NekoCoaster/inf2004-embedded-systems-project/dashboard/README.md

# MQTT Dashboard 
The MQTT Dashboard visualise the Urban Farming sensor readings transmitted to the MQTT Broker. The implementation incorporates references from the associated GitHub repository: https://github.com/donskytech/mqtt-custom-dashboard-node-js
  
## Getting Started
### Setup
Ensure that Node.js is installed on your workstation.

Install the dependencies and run the project
``` npm install && npm run dev ```

## Access the Dashboard
Visit http://localhost:3000/ in your web browser to access the MQTT Dashboard.
