NekoCoaster/inf2004-embedded-systems-project/drivers/FS3000_airflow_mqtt/FS3000_Rebuilt.h

#ifndef FS3000_Rebuilt_h
#define FS3000_Rebuilt_h

#include "i2c_tools.h"

#define FS3000_TO_READ 5 // Number of Bytes Read:
                         // [0]Checksum, [1]data high, [2]data low,
                         // [3]generic checksum data, [4]generic checksum data

#define FS3000_DEVICE_ADDRESS 0x28 // Note, the FS3000 does not have an adjustable address.
#define AIRFLOW_RANGE_7_MPS 0x00   // FS3000-1005 has a range of 0-7.23 meters per second
#define AIRFLOW_RANGE_15_MPS 0x01  // FS3000-1015 has a range of 0-15 meters per second

bool FS3000_begin(); // Initialize I2C Port in here
bool FS3000_isConnected();
uint16_t FS3000_readRaw();
float FS3000_readMetersPerSecond();
float FS3000_readMilesPerHour();
void FS3000_setRange(uint8_t range);

void FS3000_readData(uint8_t *buffer_in);

/*
 * @param data_in: 5 Bytes Buffer
 * @param debug: print debug info (default: false)
 */
bool FS3000_checksum(uint8_t *data_in, bool debug);
void FS3000_printHexByte(uint8_t x);

#endif // FS3000_Rebuilt_h
