NekoCoaster/inf2004-embedded-systems-project/(commit log)

2023-10-08 Added documentation for 5V PWM Fan Driver
2023-10-08 Updated README.md for 5v-pwm-fan driver, and added .drawio file for circuit diagram
2023-10-10 Updated README.md for the 5v-pwm-fan driver
2023-10-21 Added base PWM fan driver code...
2023-11-12 De-coupled source code and docs, added lwip testing code & cleaned house
2023-11-13 Added MQTT Test Code and patched lwipopts.h to fix sys_timeout: timeout != NULL, pool MEMP_SYS_TIMEOUT is empty
    [lwipopts.h]
2023-11-13 Added WS2812B driver code
2023-11-13 Updated led test code to use my favorite colours instead
2023-11-20 Added a bunch of goodies
    Added new i2c_tools which is a Re-Written version of Arduino-Pico's Wire.h and some Arduino.h functions combined into 1 C file to provide the most commonly used Wire.h functions. Currently I2C_tools only provides Master Functions and Slave mode has not been ported over for the sake of simplicity and keeping to our scope of requirements in this project.
2023-11-21 Added "i2c_tools_" prefix to all public functions as unique identifier to avoid potential naming clash
    Added "i2c_tools_" prefix to all public functions accessed by other libraries as a means of a unique identifier to avoid potential naming clash with other libraries.
    [MLX90614_rebuilt.c]
2023-11-29 Added driver codes
    To be documented
2023-11-29 Updated WS2812B driver for all sensor_mqtt projects
2023-11-30 Added code comments for fan
2023-11-30 Fixed a couple of bugs
    [NFA4X10_pwm_fan_mqtt.c]
2023-11-30 Added config to allow indication of spectro sensor topic prefix
2023-11-30 Added documentation and commenting to i2c_tools
